hammsyah/LC-Meter/README.md

# LC-Meter
 LC meter
# 16F628 dari https://sites.google.com/site/vk3bhr/home/index2-html?authuser=0
# Atmega8 dari https://hackaday.io/project/11932-inductance-meter
