hammsyah/LC-Meter/16F628/LC Meter.JPG

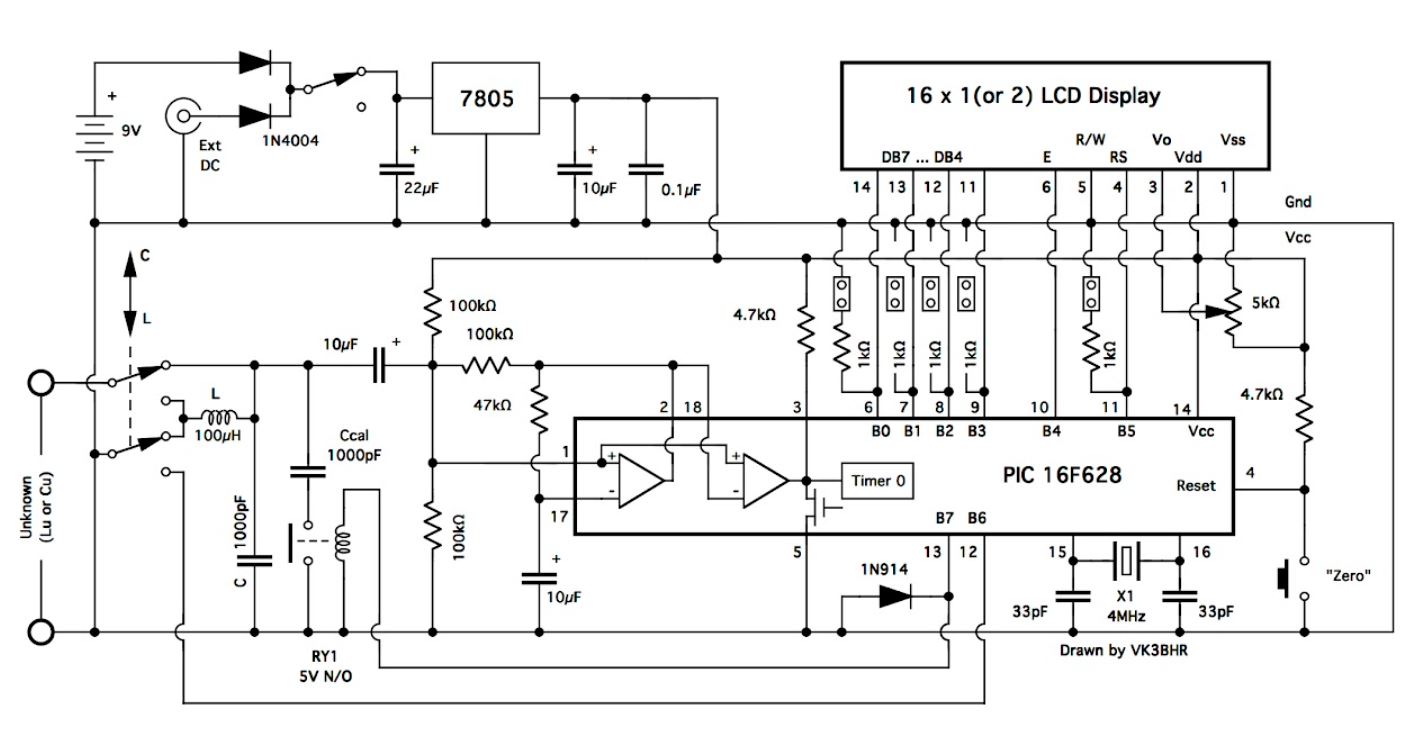
16F628/LC Meter.JPG
