hammsyah/LC-Meter/16F628/Masking 1.jpg

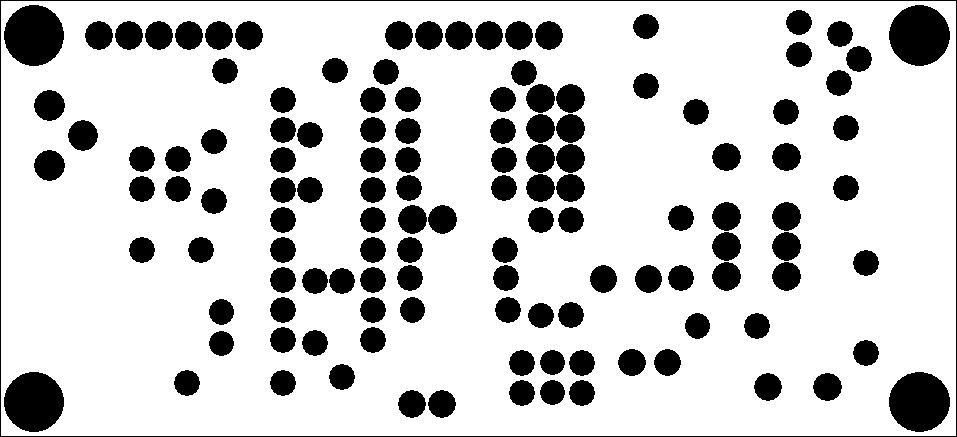
16F628/Masking 1.jpg
