hammsyah/LC-Meter/16F628/MASKING 2.jpg

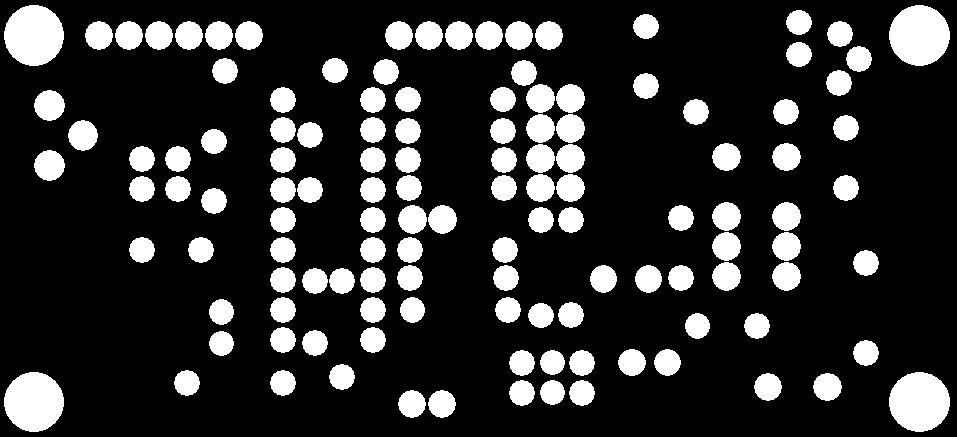
16F628/MASKING 2.jpg
