hammsyah/LC-Meter/16F628/PCB Atas.jpg

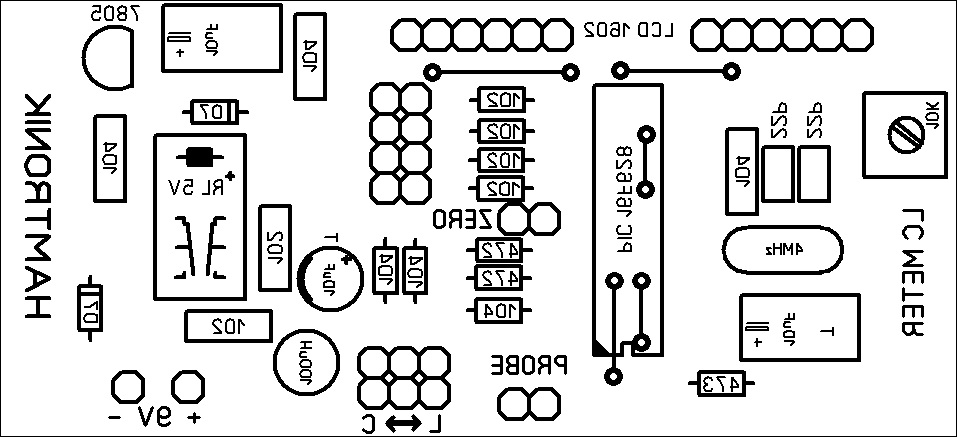
16F628/PCB Atas.jpg
