hammsyah/LC-Meter/16F628/PCB Bawah.jpg

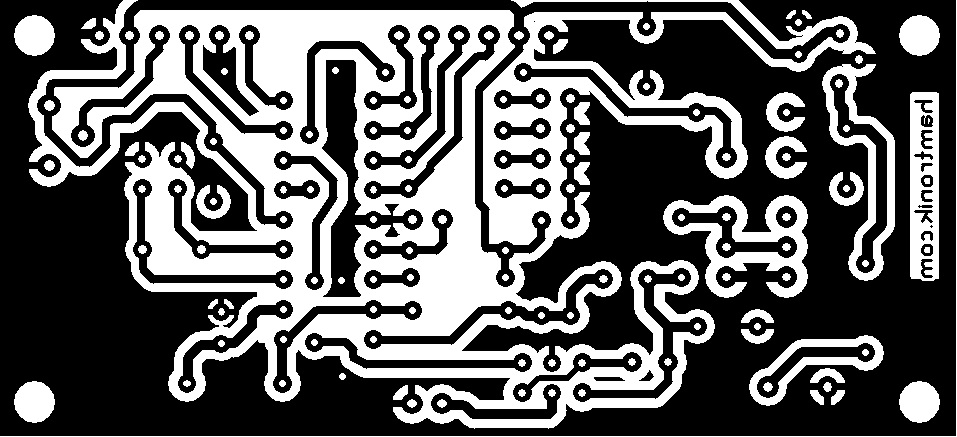
16F628/PCB Bawah.jpg
