hammsyah/LC-Meter/16F628/PCB Hamtronik/lc meter 81x37mm.JPG

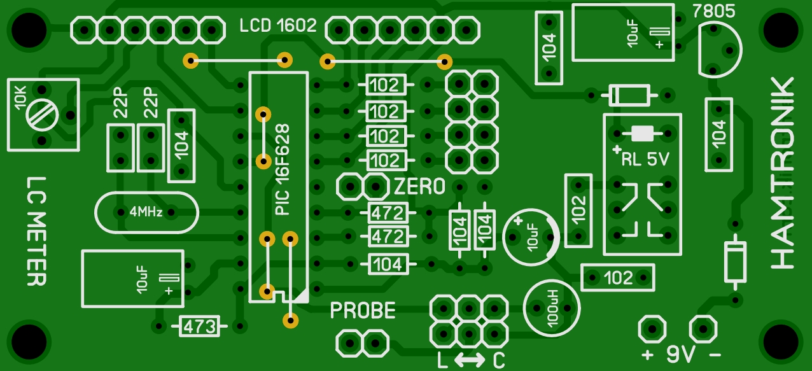
16F628/PCB Hamtronik/lc meter 81x37mm.JPG
