hammsyah/LC-Meter/16F628/PCB Hamtronik/lc meter atas.jpg

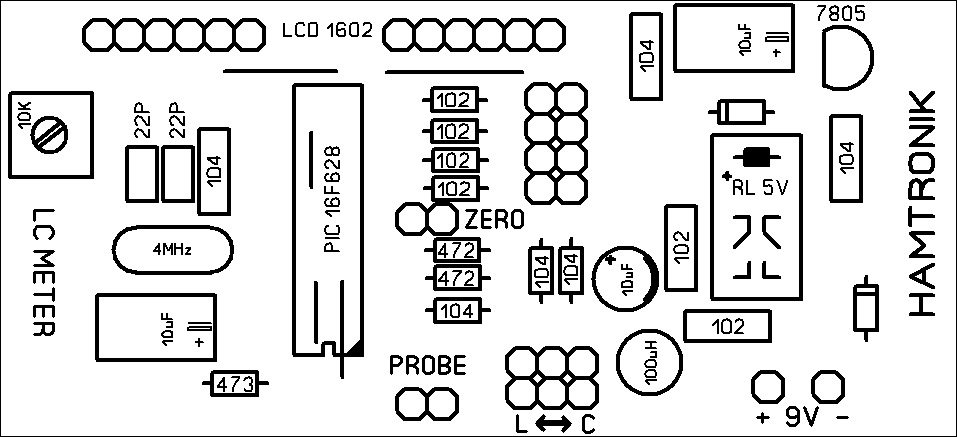
16F628/PCB Hamtronik/lc meter atas.jpg
