hammsyah/LC-Meter/16F628/PCB LC Meter.JPG

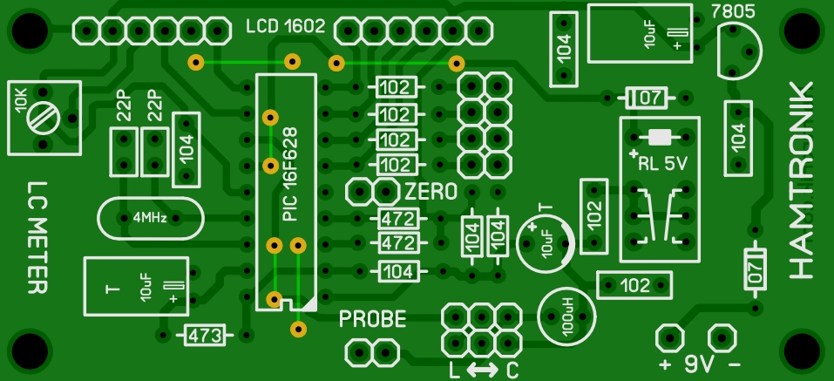
16F628/PCB LC Meter.JPG
