hammsyah/LC-Meter/16F628/LCM2.pdf

## 16 x 1(or 2) LCD Display

7805

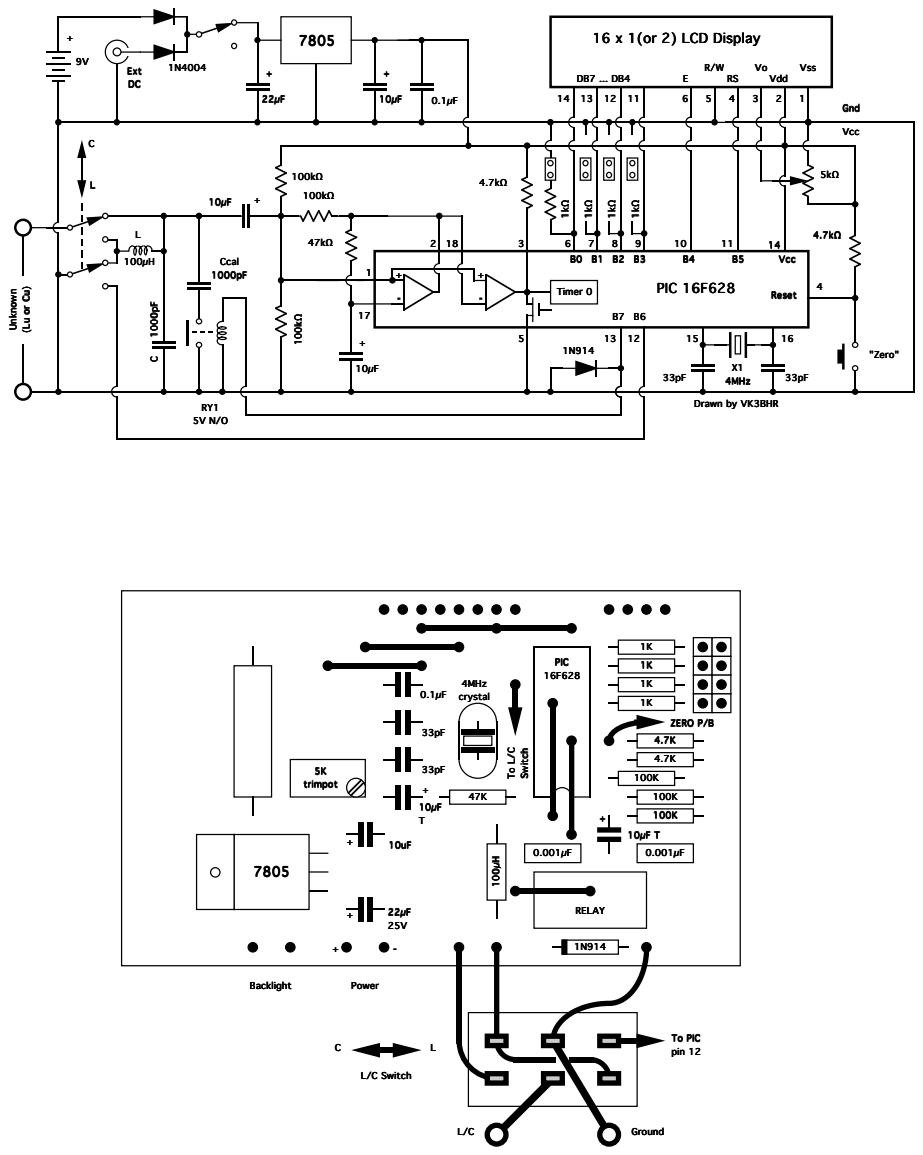
[picture p11: page 1]
Ccal 1000pF; PIC 16F628; "Zero"; Unknown; Ext DC; Gnd; Vcc; Drawn by VK3BHR; Vdd; Vss; X1 4MHz; - Timer 0; Reset; 4MHz crystal; Power; ZERO P/B; Backlight; 5K trimpot; Switch; RELAY; To PIC pin 12; Ground; L/C Switch
