hammsyah/LC-Meter/Atmega8/Inductance Meter LM393.pdf

U3

C1

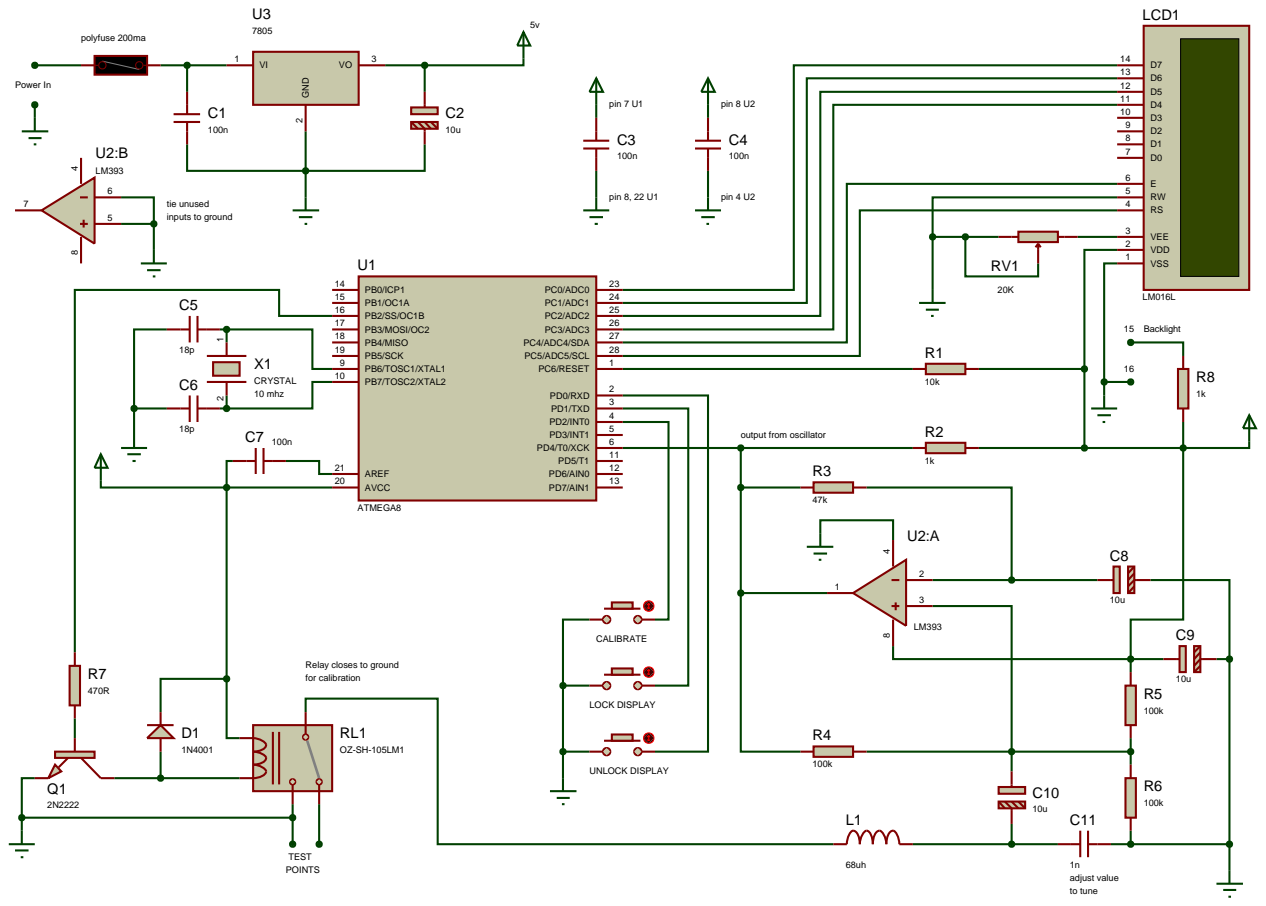
[picture p12: page 1]

Relay closes to ground
for calibration
