hammsyah/LC-Meter/(list of files, drawings)

Other design files:
16F628/LC Meter.lay6
