hammsyah/LC-Meter/16F628/link test.PNG

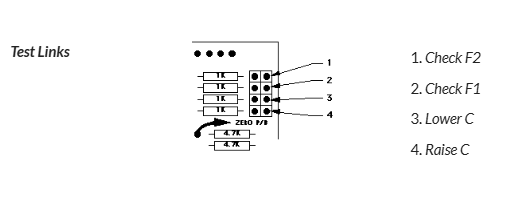
16F628/link test.PNG
